NicovrauG/TCC/prj/README.md

# Esse diretório é onde os códigos do protótipo são encontrados.
 - `back/` — servidor e scripts para processamento.
 - `dados_e_videos/` — diretório necessário para funcionamento do protótipo, armazenamento das coletas em disco.
 - `esp_code/` — firmware e configurações para o microcontrolador.
 - `front/` — páginas web para visualização.
 - `hardware/` — informações técnicas sobre os componentes utilizados.
