NicovrauG/TCC/prj/dados_e_videos/README.md

# Este diretório é necessário para o funcionamento do protótipo, é onde são salvos os dados das coletas.
