NicovrauG/TCC/prj/front/README.md

# Esse diretório é dedicado para o armazenamento das páginas correspondentes ao frontend do protótipo.
 - `index.html` - página referente aos pacientes cadastrados.
 - `paciente.html` - página referente a um paciente e seu histórico de coletas.
