NicovrauG/TCC/(commit log)

2025-09-30 Update front.html
    Added buttons xD
2025-10-11 Update front.html
    Mudado para unicamente registro de pacientes
2025-10-11 Create paciente.html
    Novo arquivo (página de coletas do paciente)
2025-10-21 Migrei para PlatformIO
2025-10-21 Create platformio.ini for ESP32-S3 project
    Added PlatformIO configuration for ESP32-S3 Dev Kit.
2025-11-10 Enhance upload_mobile to process video and angles
    Updated the upload_mobile endpoint to handle video and angles upload, ensuring proper file management and database insertion.
2025-11-13 Refactor data collection and peak detection logic
    Adjusted filtering parameters based on real sampling frequency and improved peak detection logic. Added area calculation for detected peaks and enhanced plotting functionality.
2025-11-14 Fix print statement for ffmpeg error handling
2025-11-14 Change database name and configure video device
    Updated database name and added video device configuration.
2025-11-29 Update README with corrected paths and new section
    Corrected directory name for ESP32 code and added schematic section.
2025-11-29 Fix image syntax in README for schematic
2025-11-29 Revise a seção de execução no README
    Atualiza a seção 'Como Executar' com instruções detalhadas.
2025-11-29 Update README to remove ESP32 ports section
    Removed section about ESP32 ports and image.
2025-11-29 Enhance README with detailed ADS1115 information
    Expanded the README to provide detailed information about the ADS1115 ADC, including features, pinout, I2C addressing, operation modes, and wiring instructions.
2025-11-29 Include sensor positioning example in README
    Added example of surface electromyography sensor positioning.
2025-11-29 Add positioning example for surface EMG sensor
2025-11-29 Revise README.md para o sensor EMG SEN0240
    Atualiza o README.md com informações detalhadas sobre o sensor EMG SEN0240, incluindo características, conexões, considerações de amostragem e boas práticas.
2025-11-29 Update I2C pin assignments in README.md
2025-11-29 Add example usage for ADS1115 with MQTT on ESP32
    This file demonstrates the usage of ADS1115 with MQTT on an ESP32, including WiFi setup and handling of control messages.
2025-11-29 Update section title for sensor positioning example
2025-12-01 Update include directive for Arduino example code
2025-12-01 Enhance YD-ESP32-23 documentation
    Expanded documentation for the YD-ESP32-23 board, including technical data, basic pinout, necessary components, recommendations, usage examples, integration details, and applications.
2025-12-02 Update README with prototype schematic
    Added schematic diagram of the prototype to the README and removed the redundant section.
2025-12-02 Add schematic section to hardware README
    Added schematic section and image reference to README.
2025-12-02 Update README with additional usage example and schematic
